pkaislan123/ESP-BALAN-A-WEB-SERVER/README.md

# ESP-BALAN-A-WEB-SERVER
Neste repositório você encontrará um projeto de balança com web server no esp

Para montar o Sistema de Pesagem Dinamica, siga a documentação proposta nos arquivos da pasta "Documentação", começando por "1) Teoria Inicial" e seguindo a ordem númerica.
