pkaislan123/ESP-BALAN-A-WEB-SERVER/Documentação/Leia-me.txt

Para montar o Sistema de Pesagem Dinamica, siga a documentação proposta nos arquivos desta pasta, começando por "1) Teoria Inicial" e seguindo a ordem númerica.
