pkaislan123/ESP-BALAN-A-WEB-SERVER/Circuito Intuitivo.png

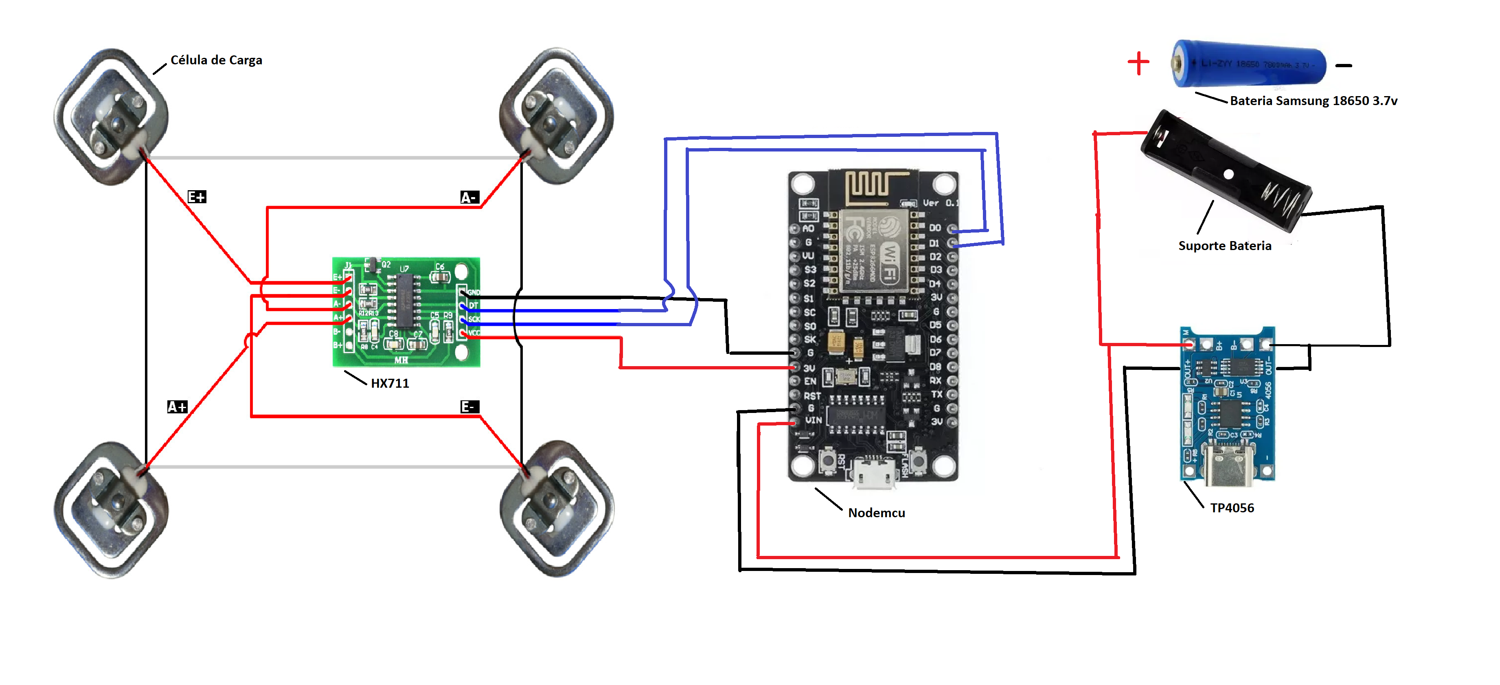
Circuito Intuitivo.png
