pkaislan123/ESP-BALAN-A-WEB-SERVER/Galeria/Modelo 3d Suporte Célula de Carga/Bandeja com Células de Carga Instaladas - Visão Superior.png

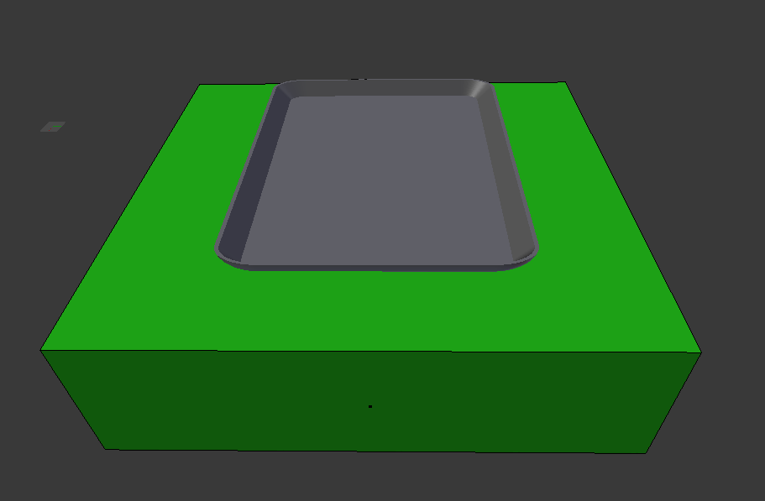
Galeria/Modelo 3d Suporte Célula de Carga/Bandeja com Células de Carga Instaladas - Visão Superior.png
