pkaislan123/ESP-BALAN-A-WEB-SERVER/Galeria/Modelo 3d Suporte Célula de Carga/Suporte Célula de Carga e Célula de Carga Instalada - Visão Ponto de Apoio.png

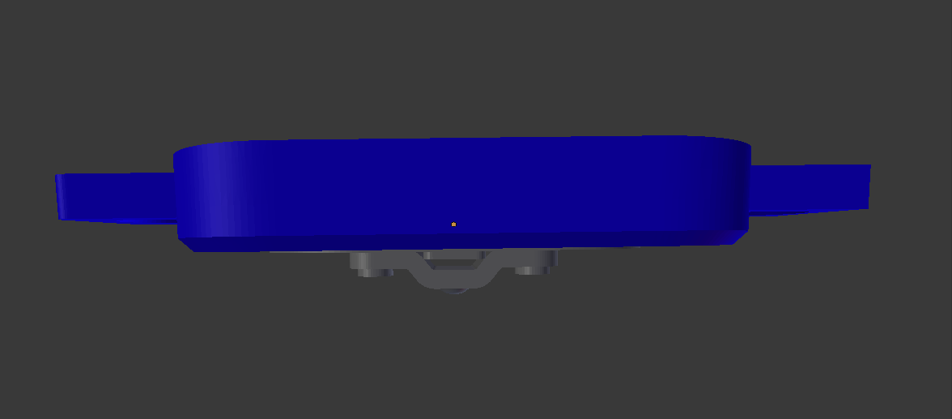
Galeria/Modelo 3d Suporte Célula de Carga/Suporte Célula de Carga e Célula de Carga Instalada - Visão Ponto de Apoio.png
