pkaislan123/ESP-BALAN-A-WEB-SERVER/Galeria/Modelo 3d Suporte Célula de Carga/Suporte Célula de Carga.png

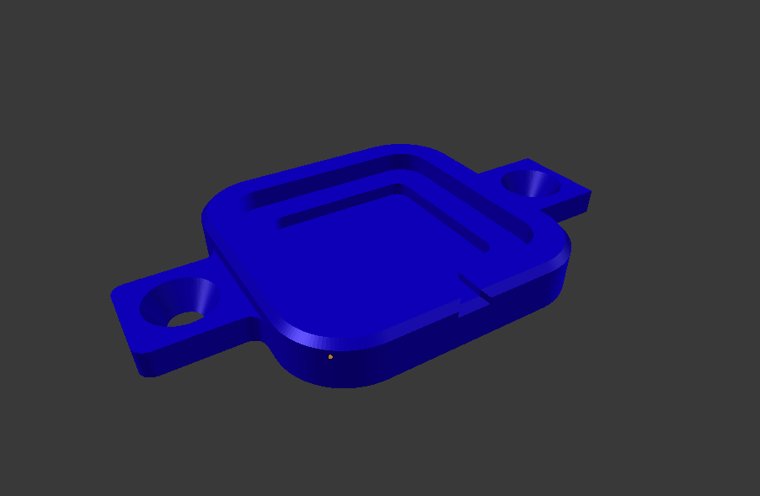
Galeria/Modelo 3d Suporte Célula de Carga/Suporte Célula de Carga.png
