pkaislan123/ESP-BALAN-A-WEB-SERVER/Modelo 3d Suporte Célula de Carga/Modelo 3d Suporte Balança.stl

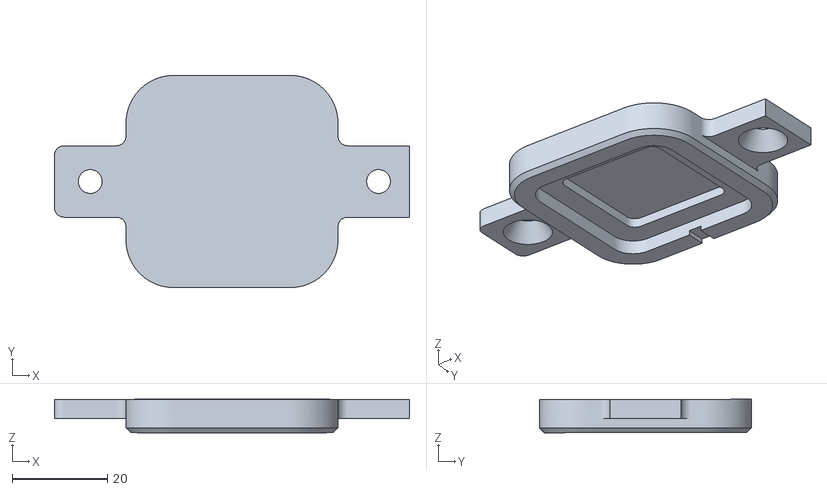
[picture p24: CAD file, 2023-10-18]
Modelo 3d Suporte Célula de Carga/Modelo 3d Suporte Balança.stl
74.5 x 44.5 x 7.04
